constral/MC14500-Breadboard-Computer/original_schematic.jpg

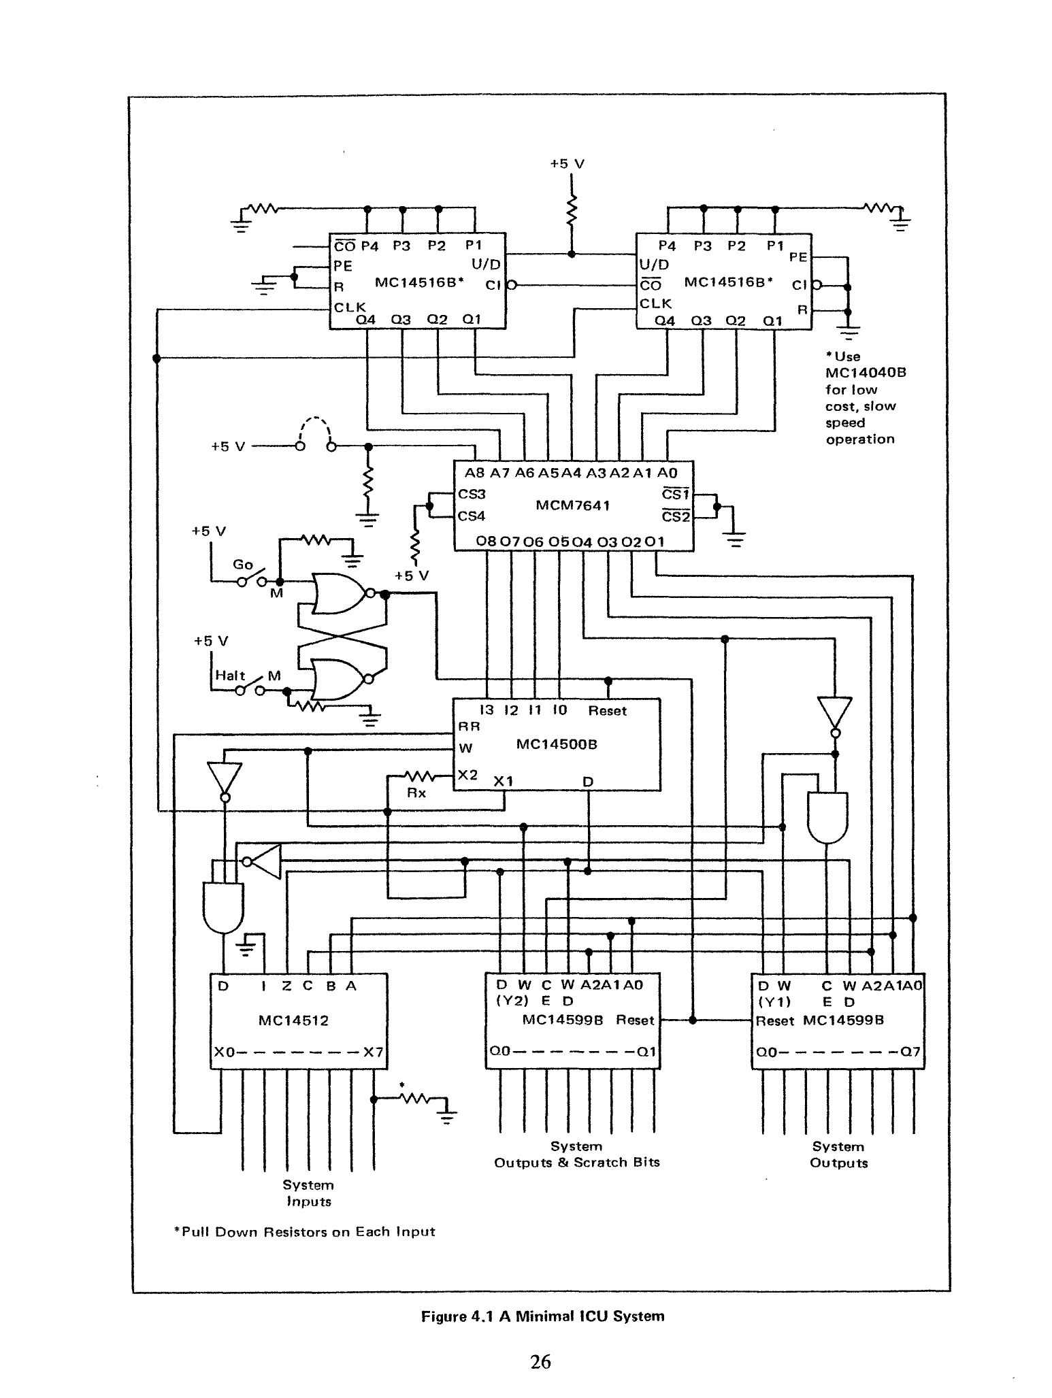
original_schematic.jpg
